ncknight-un/Quadruped_Rudy/rudy_description/README.md

# Rudy Description

URDF model for Rudy to launch in Rviz simulations.
