ncknight-un/Quadruped_Rudy/media/Rudy_Elec_Layout.jpeg

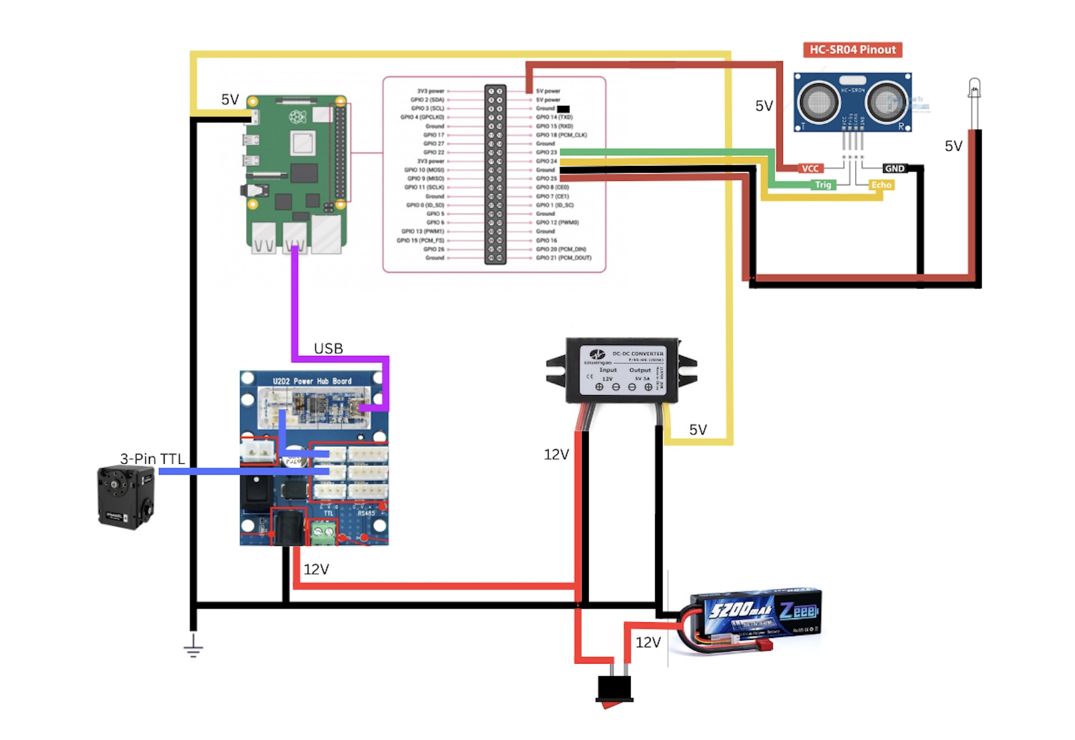
media/Rudy_Elec_Layout.jpeg
