ncknight-un/Quadruped_Rudy/rudy_description/meshes/Dual_Motor_Collision.stl

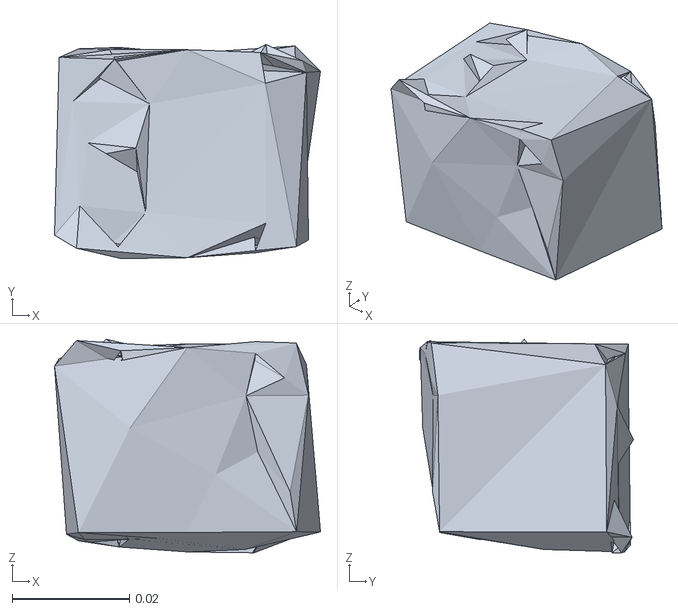
[picture p4: CAD file, 2026-02-03]
rudy_description/meshes/Dual_Motor_Collision.stl
0.0453 x 0.0365 x 0.0364
