ncknight-un/Quadruped_Rudy/rudy_description/meshes/Foot_Link_Collision.stl

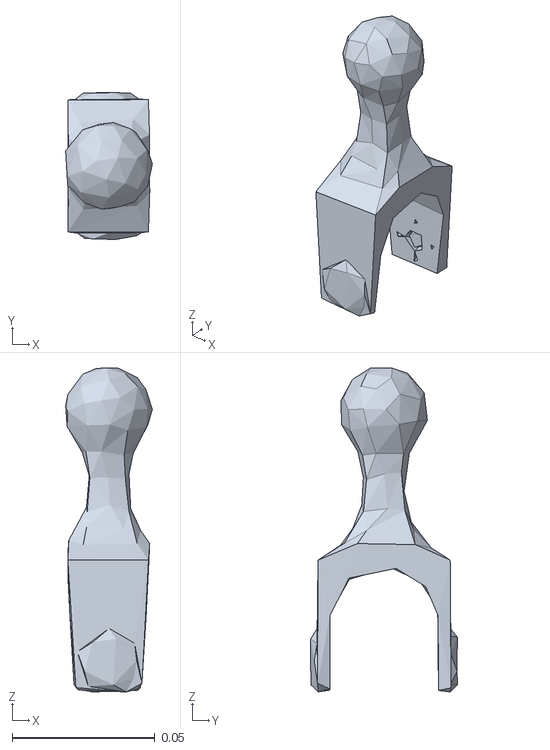
[picture p5: CAD file, 2026-02-03]
rudy_description/meshes/Foot_Link_Collision.stl
0.0304 x 0.0514 x 0.113
