ncknight-un/Quadruped_Rudy/rudy_description/meshes/Body_Link.stl

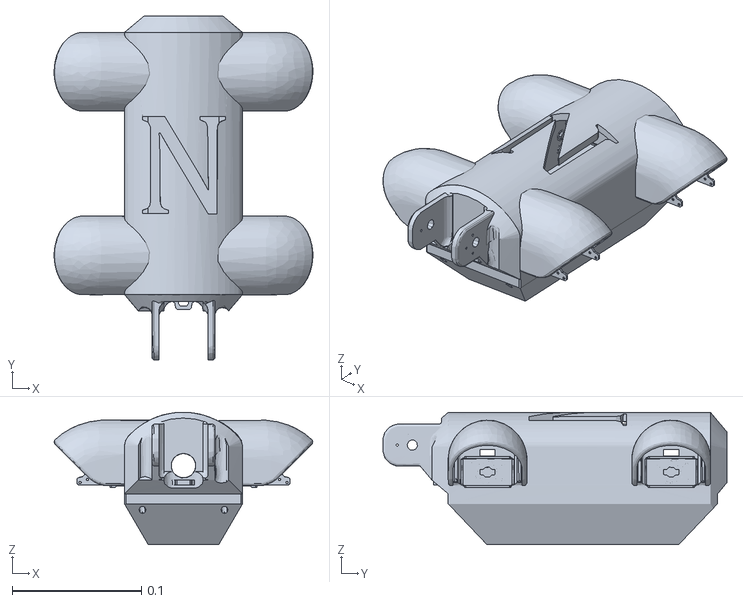
[picture p6: CAD file, 2026-02-03]
rudy_description/meshes/Body_Link.stl
0.2 x 0.266 x 0.103
