ncknight-un/Quadruped_Rudy/rudy_description/meshes/DualMotor_Link.stl

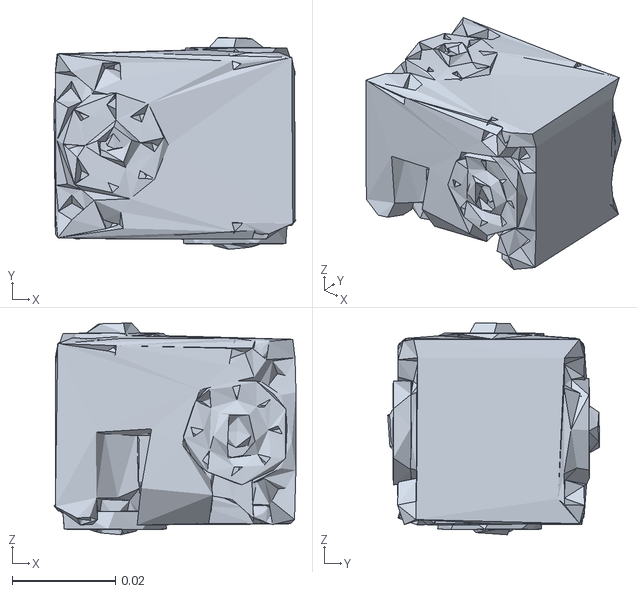
[picture p7: CAD file, 2026-02-03]
rudy_description/meshes/DualMotor_Link.stl
0.0469 x 0.041 x 0.041
