ncknight-un/Quadruped_Rudy/rudy_description/meshes/Body_Link_Collision.stl

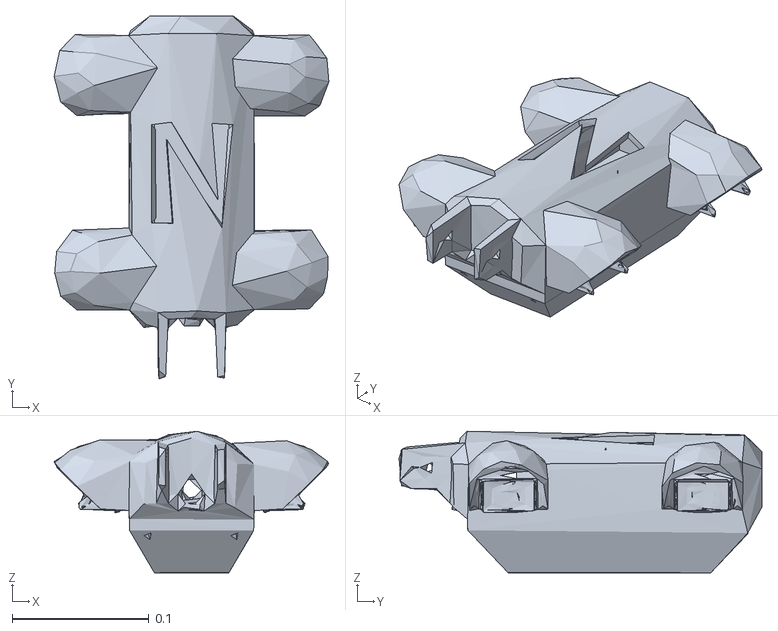
[picture p8: CAD file, 2026-02-03]
rudy_description/meshes/Body_Link_Collision.stl
0.201 x 0.266 x 0.104
