ncknight-un/Quadruped_Rudy/rudy_description/meshes/Foot_Link.stl

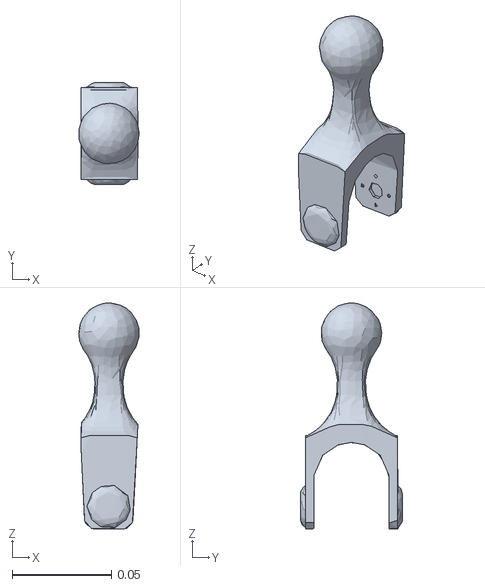
[picture p9: CAD file, 2026-02-03]
rudy_description/meshes/Foot_Link.stl
0.0305 x 0.0516 x 0.114
