ncknight-un/Quadruped_Rudy/rudy_description/meshes/Dual_Motor.stl

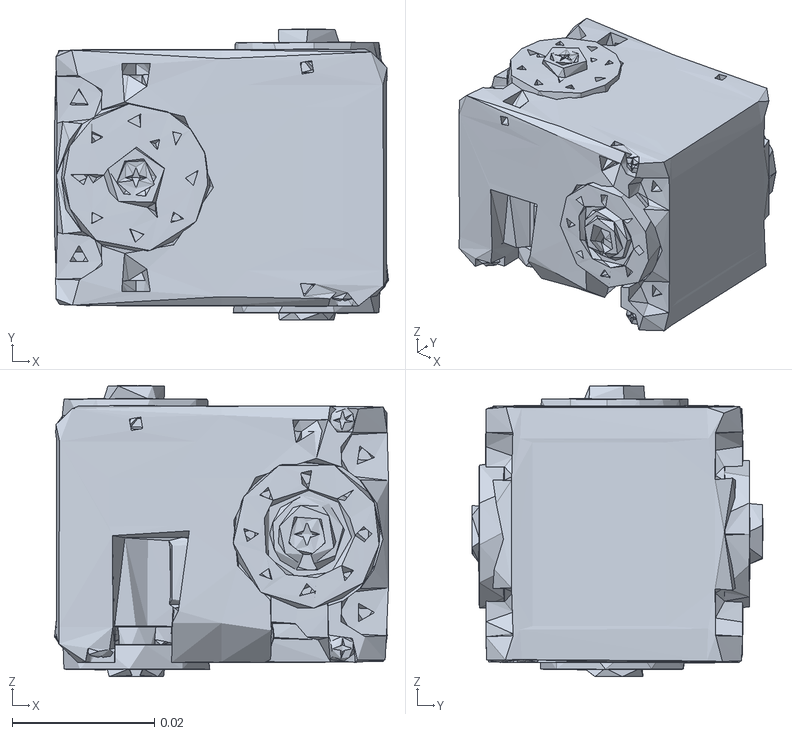
[picture p10: CAD file, 2026-02-03]
rudy_description/meshes/Dual_Motor.stl
0.0469 x 0.0409 x 0.0409
