ncknight-un/Quadruped_Rudy/rudy_description/meshes/Head_Link_Collision.stl

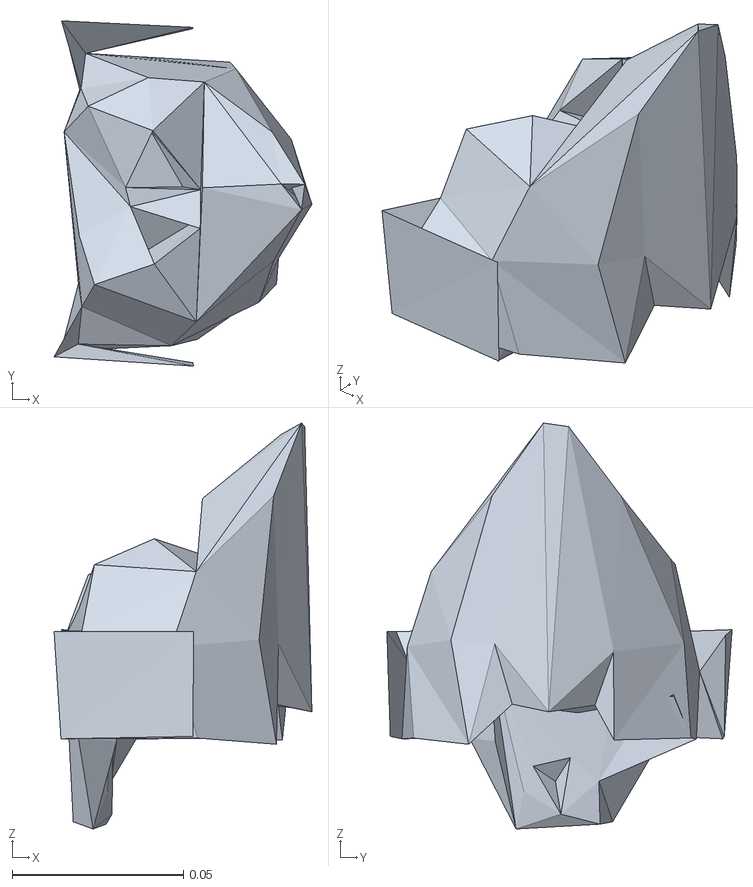
[picture p11: CAD file, 2026-02-03]
rudy_description/meshes/Head_Link_Collision.stl
0.0754 x 0.101 x 0.119
