ncknight-un/Quadruped_Rudy/rudy_description/meshes/Hip_Link.stl

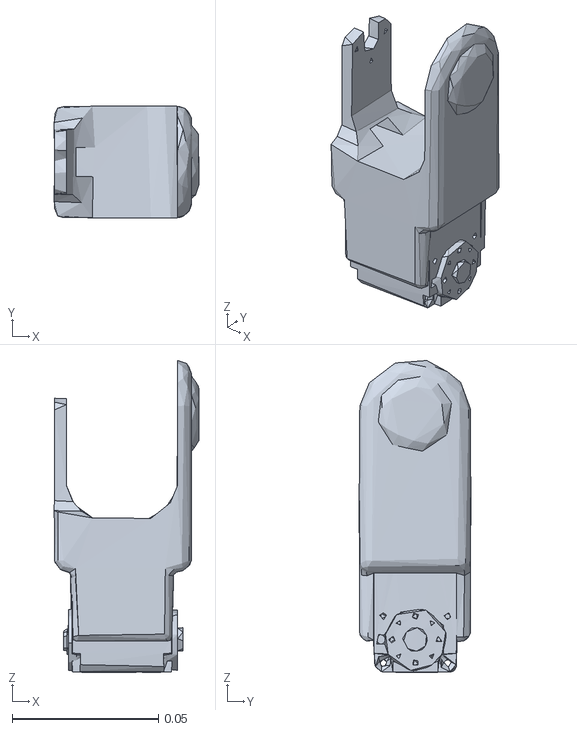
[picture p12: CAD file, 2026-02-03]
rudy_description/meshes/Hip_Link.stl
0.0494 x 0.0381 x 0.107
