ncknight-un/Quadruped_Rudy/rudy_description/meshes/Hip_Link_Collision.stl

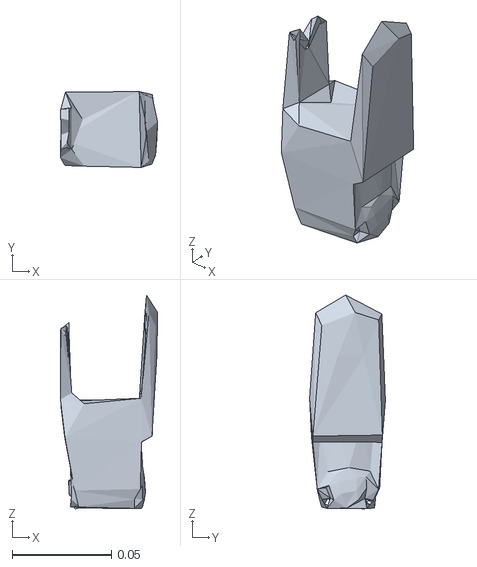
[picture p13: CAD file, 2026-02-03]
rudy_description/meshes/Hip_Link_Collision.stl
0.0489 x 0.0382 x 0.108
