ncknight-un/Quadruped_Rudy/rudy_description/meshes/Head_Link.stl

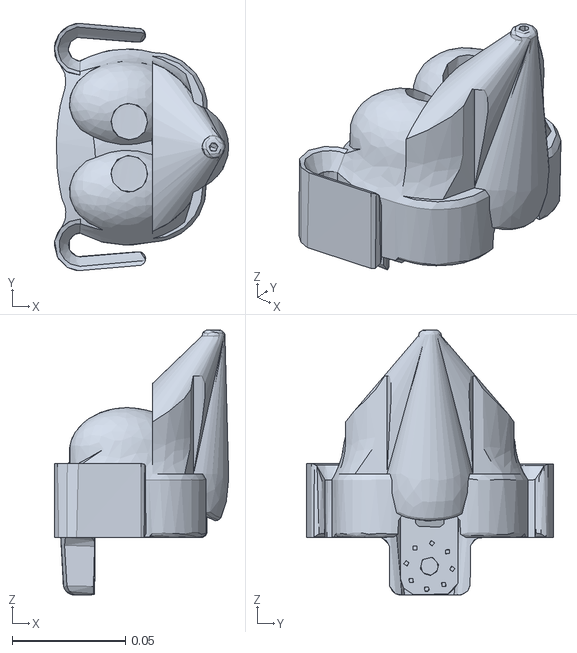
[picture p14: CAD file, 2026-02-03]
rudy_description/meshes/Head_Link.stl
0.0769 x 0.109 x 0.117
