ncknight-un/Quadruped_Rudy/rudylib/doc/Rudy_LegKinematics.pdf

p

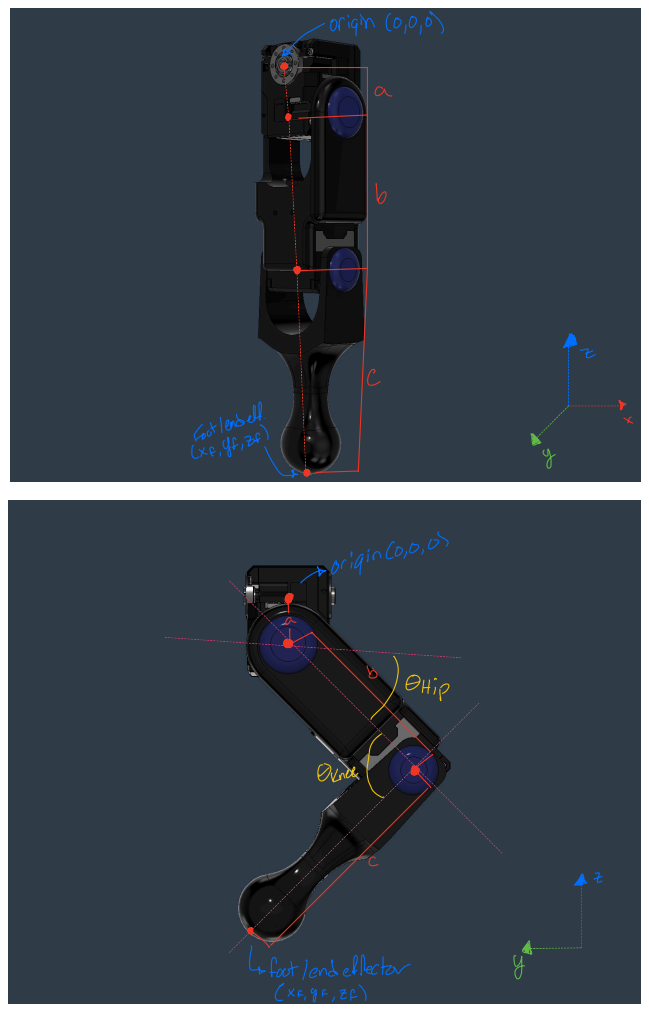
[picture p15: page 1]
origin 010,07; originco0,01; Hip; knee; AsZ; footendeflector

Cxe.ge Zfl

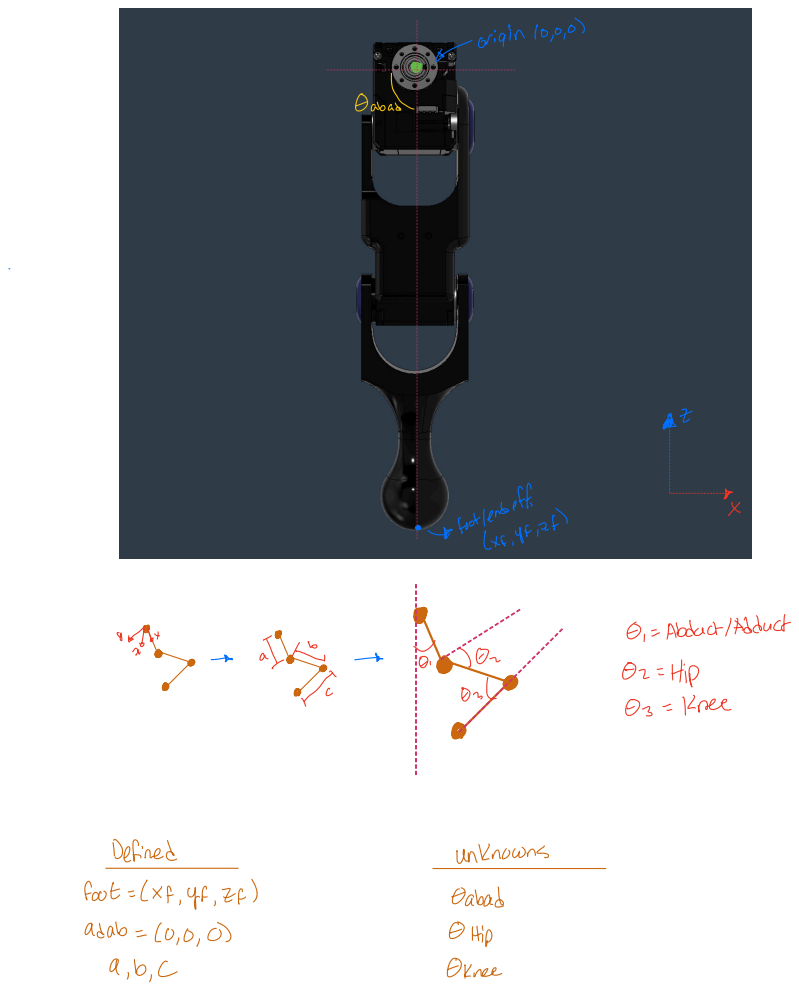
[picture p16: page 2]
origin¹⁰,0,0; Qabala; tootle; AbductAdduct r; 02 Hip of; onto; 03 Knee; Defined; unknowns; foot Xf Yf Zfl; Gabad; Adab 0,0 c; Hip; Okree

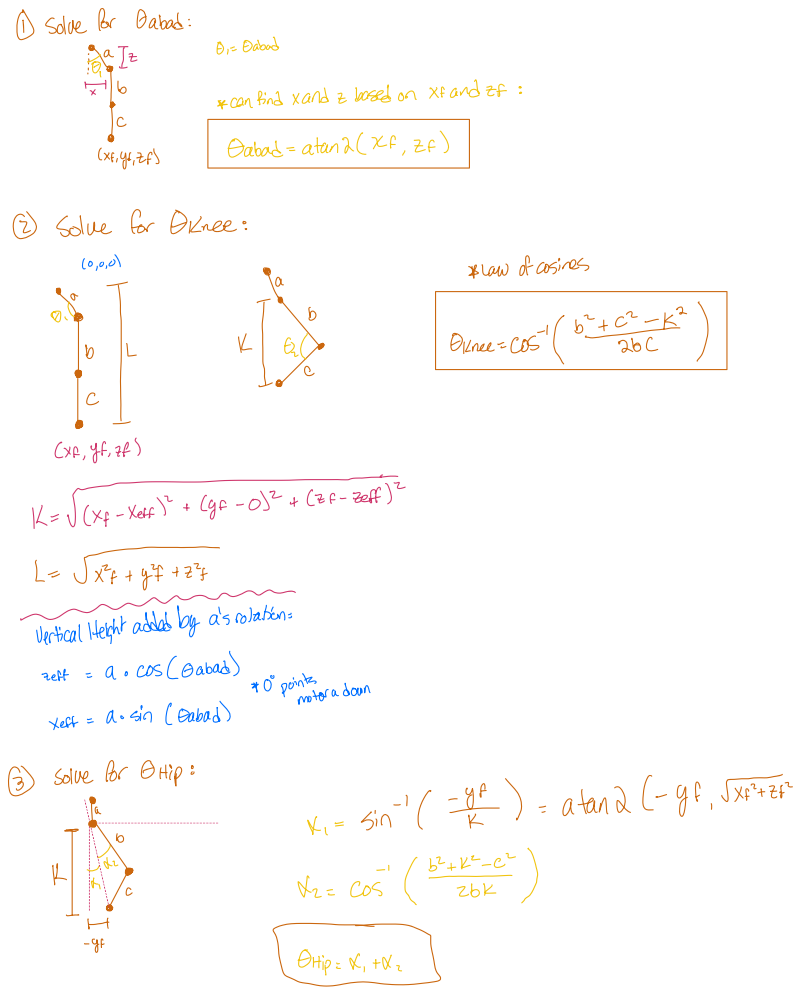
[picture p17: page 3]
Solvefor Gabad; OrOabad; ftp.zf; Oabad atan2 Xf Zf; toand; law ofcosines; One cost; K Xf Xefftf yf; ZF zeffT; AFEFYF Trainariration; zeff; a Cos Gabad; 0pointforadown; Solvefor Hip; sin; atan2C yf.EE; α cos 575; OHip X

canfind and z basedon XfandZf

Solve for knee

Xeff A sin Gabad

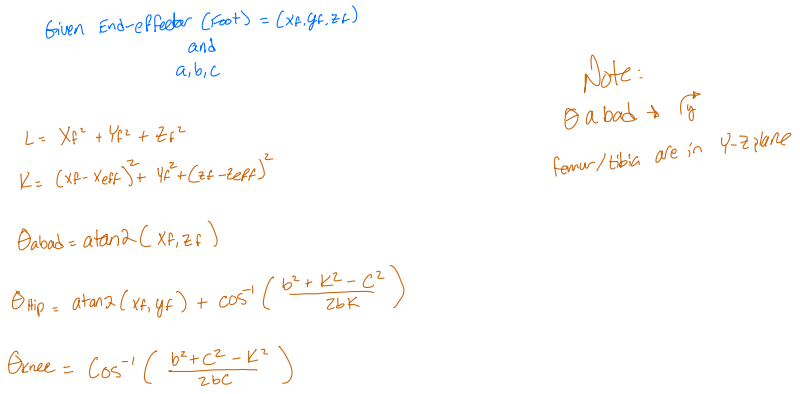
[picture p18: page 4]
Given Endeffector Foot; Note abad Fy; K Xf effftYf zf Zeff; femurtibia are in Y Z are; Hip atana Yf yf; cost; biff; knee; Cost; Ege

L Xf YF² Zf

Fabad atan2 Xf Zf
