ncknight-un/Quadruped_Rudy/quadruped_behavior/config/motor_params.yaml

/**:
  ros__parameters:
    motor_ids: [11,1,2,13,3,4,15,5,6,17,7,8,9,10]
    motor_calib_offsets: [2048, 2048, 2048, 2048, 2048, 2048, 2048, 2048, 2048, 2048, 2048, 2048, 2048, 2048]
    encode_ticks_per_rad: 652
    max_encoder_value: 4095
    profile_velocity: 1200
    profile_acceleration: 600
    frequency: 20.0
