ncknight-un/Quadruped_Rudy/(commit log)

2026-02-03 Created rudy_description package and created a URDF model of Rudy in Rvix. Rudy currently has an accurate collision body, visual body, and joints for all 12 DOF. The next step is to finish filling in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
    [Body_Link.stl, Body_Link_Collision.stl, DualMotor_Link.stl, Dual_Motor.stl, Dual_Motor_Collision.stl, Foot_Link.stl, Foot_Link_Collision.stl, Head_Link.stl]
2026-02-11 started calibration node. Taking a break. Will come back to this soon
2026-02-13 Removed Unneeded packages and finished calibration node. Going to test on Rudy Now.
    [motor_params.yaml, rudy_us.urdf.xacro]
2026-02-13 Calibrated motors and saved to a yaml file for first model rudy
    [motor_calibration.yaml]
2026-02-13 Added Leg Kinematics. Need to make adjustments, and will test soon
2026-02-18 Finished Leg Kinematics and testing for FK and IK. I had a few small issues where I forgot to flip z and normalize the knee angle.
2026-02-18 Wrote a static poses publisher for the physical robot that can run Rviz alongside it. Testing on Pi soon
    [motor_params.yaml]
2026-02-18 Fixing torque enabling for motor driver
    [Static_Position.cpp]
2026-02-18 Fixing bugs with torque still
    [Static_Position.cpp]
2026-02-18 Torque issue and Rviz
    [Static_Position.cpp]
2026-02-18 Forgot to open ports, seeing if this is the issue again
    [Static_Position.cpp]
2026-02-18 still attempting to fix motor set up for state publishing
    [Static_Position.cpp]
2026-02-18 I can now send messages to all the motors at once. I need to work on making it continuosly keep torque enabled. After it runs, the torque turns off. Next step is to look into that. I am also not seei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
2026-02-19 Trying to fix motor publishing
    [motor_params.yaml]
2026-02-19 Fixing timer
2026-02-19 joint publisher test
2026-02-19 Trying to fix encoder reading
    [Static_Position.cpp]
2026-02-19 Torque disable at shutdown:
2026-02-19 Fixed calibration offset. I was adding it twice
    [Static_Position.cpp]
2026-02-19 Fixing torque disable again
    [Static_Position.cpp]
2026-02-19 Updating joint positions to see if it works better
2026-02-19 Trying to debug joint publishing
2026-02-19 Trying to work on publication rate. Think messages are colliding and dropping
    [Static_Position.cpp]
2026-02-19 Trying to fix zeroing in motor response
    [motor_params.yaml]
2026-02-19 Trying to fix go to position for all motors?
    [Static_Position.cpp]
2026-02-19 removed joint pos offset
2026-02-19 Changed it so the new joint state is only published when the new state is updated.
2026-02-20 lay down and stand up almost working with position control. I am going to ask Matt tomorrow if I should switch to velocity control. I also need to figure out how to send commands in sync, because 1 a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
    [motor_params.yaml]
2026-02-20 Added additional static poses to Rudy. Next steps are to smooth the state transitions, and go back to working on the kinematics.
    [motor_params.yaml]
2026-02-25 Workeqd on body kinematics, and changed custom struct Point3D to Eigwen:Vector3D for all kinematics files. Working on writing testing now for body kinematics
    [motor_params.yaml]
2026-02-25 Attempted to add a pose waypoint sim of walking.
    [motor_params.yaml]
2026-02-25 Trying to fix walking phase
    [Static_Position.cpp]
2026-02-25 Trying to fix walking sim issue
    [Static_Position.cpp]
2026-02-25 Flipping knee angle for right legs
    [Static_Position.cpp]
2026-02-25 Fixed leg movement in seq
    [Static_Position.cpp]
2026-02-25 fix small swing bugs
    [Static_Position.cpp]
2026-02-25 Trying to fix seg fault
    [Static_Position.cpp]
2026-02-25 Working on cleaning up Quasi-static gait. Need more lift off in the back legs
2026-03-03 Updating code to add dynamixel interface to reduce Node size. Attempting to fix QS gait
    [Static_Position.cpp]
2026-03-04 Updated Joint states and acceleratiosn
    [motor_calibration.yaml]
2026-03-04 Attempting to test joint publication as a packet publication to reduce latency in each motor movement
2026-03-04 Fixing unneccessary line in new function
    [Static_Position.cpp]
2026-03-04 Increased speed on motor acceleration
    [motor_params.yaml]
2026-03-04 Fix build issues. Walk still inactive
    [Static_Position.cpp]
2026-03-04 Synced parameter files and attempted to log motor torque reset fail
    [motor_params.yaml]
2026-03-04 Fixing motor mapping
    [motor_params.yaml]
2026-03-04 Added a function in to flip the angle signs for abad and knee on right side
    [Static_Position.cpp]
2026-03-04 Fixed array/vector issue in my process_pose function
    [Static_Position.cpp]
2026-03-04 Fixed bug in joint pose function. Was forgetting to add left legs to sequence
    [Static_Position.cpp]
2026-03-04 Attempting to increase leg thrust. Current model is still not walking forward
2026-03-04 Trying to fix thrust phase
    [Static_Position.cpp]
2026-03-04 Trying new thrust method. Offsettign static legs by half a cycle.
2026-03-04 Lowering COM, slowing speed of leg movement, and adding latency between phase shifts
    [motor_params.yaml]
2026-03-04 increaseing speed again redducing COM further
    [motor_params.yaml]
2026-03-04 Tryig to reverse thrust phase, because it is moving backwards...
2026-03-04 Trying to fix phase shifting
    [Static_Position.cpp]
2026-03-04 params update to straighten leg more
2026-03-04 Trying to add push off in the landing to push forward.
2026-03-04 Trying to speed leg cycle and reduce redundants
    [motor_params.yaml]
2026-03-04 gaits stuffs
    [motor_params.yaml]
2026-03-04 red timer freq
    [motor_params.yaml]
2026-03-04 Robot is walking backwards again, but I am trying to switch forward
    [motor_params.yaml]
2026-03-04 Increased Frequency and moved knees up/removed abad (caused abad motor failure - think).
    [motor_params.yaml]
2026-03-06 Updating walking and static standing parameters, and attempting to increase walking speed
    [motor_params.yaml]
2026-03-07 Testing moving foot forward more during step - Test A.1
    [motor_params.yaml]
2026-03-07 Testing moving foot forward more during step - Param Revert. Slight more leg lift
2026-03-07 Testing to seeq if front legs with more bend gives more forward drive
2026-03-09 Attempting to increase trot speed, and timer frequency for gait
    [motor_params.yaml]
2026-03-09 Increased timer freq. Dog gait is now quicker. I'd like to clean up the motion now to get more push off with each step
    [motor_params.yaml]
2026-03-09 Pushing to try to change bend in front legs offset to be at the back
2026-03-09 rear leg offset for bend
2026-03-09 tring to bend front legs more
2026-03-09 Testing slower pace with original gait
    [motor_params.yaml]
2026-03-09 Increasing P on PID for motors to hopefully increase Torque max
2026-03-09 Doubled Torque again, in hopes of stiffening knees
    [Static_Position.cpp]
2026-03-09 Reverted Gait Params after redistributing weight in robot housing
    [Static_Position.cpp]
2026-03-09 trying to clean gait still
    [motor_params.yaml]
2026-03-09 Trying to speed up loop through the waypoints to see if it makes it smoother
    [motor_params.yaml]
2026-03-09 I have spent many iterations trying to modify my gait parameters and waypoints. I am going to test this model 1 motre time, and if its very similiar, I am going to keep it as is, and move on to clean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
    [motor_params.yaml]
2026-03-11 Final working parameters for waypoint joint state trot gait. Going to clean up github now. Will set up future tasks as well.
2026-03-16 Updated Citations. Cleaned up references and code citations. Will go back and add Tops to Kinematics Code as a reference.
2026-03-16 Updated Citation for the git repository I referenced for my Leg Kinematics. Added source to gait category.
2026-03-16 Cleaned up config file for static poses and leg trajectory. I removed all my repeated redundant comments. I also removed redundancies in code and changed the citation numbers to appropriate values. P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
2026-04-15 Added Simulation of leg trajectory from kinematic model
